imdolce/ws2812b-5050-10x10/schematic/SCH_5050-v1.1_1-P1_2026-10-26.png

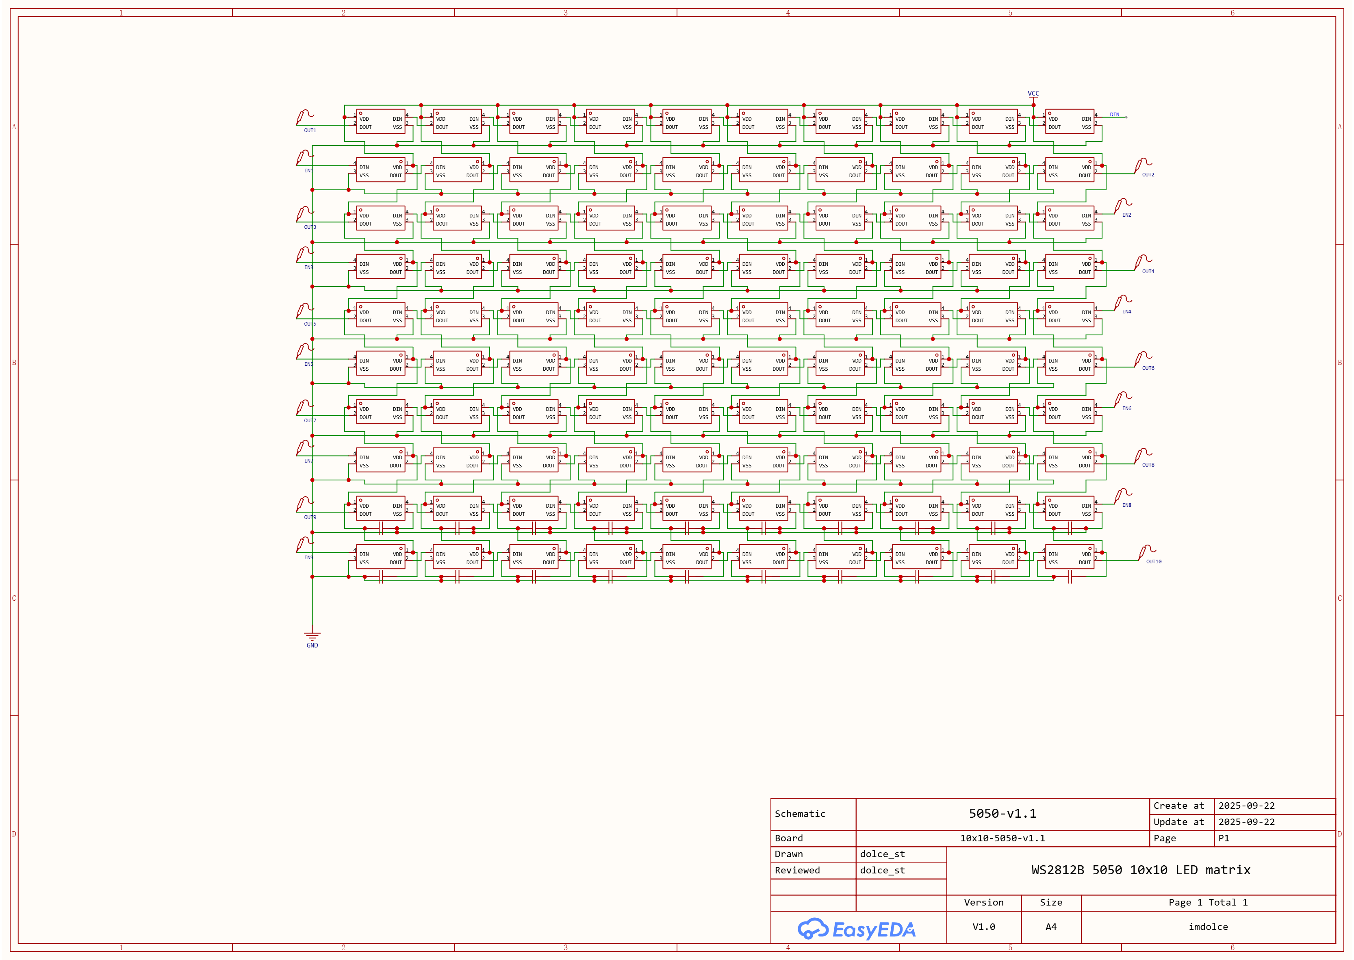
schematic/SCH_5050-v1.1_1-P1_2026-10-26.png
