imdolce/ws2812b-5050-10x10/cad/3D_5050-v1_2026-10-26.step

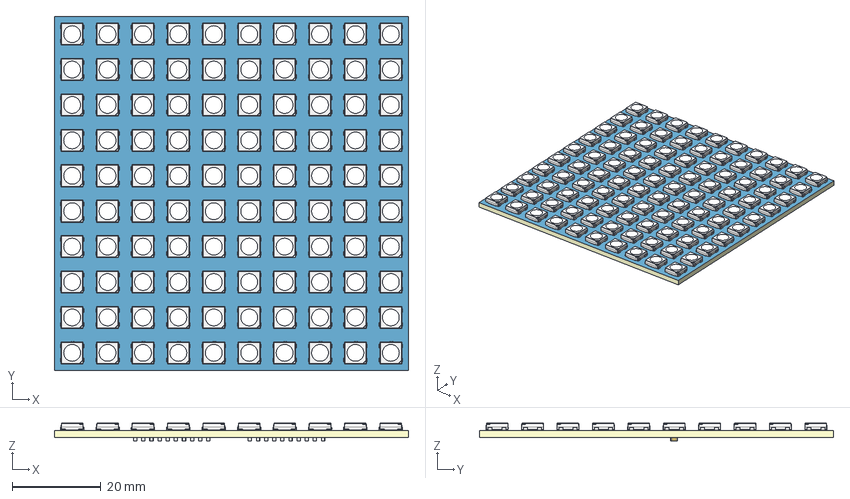
[picture p7: CAD file, 2026-10-26]
cad/3D_5050-v1_2026-10-26.step
80.0 x 80.0 x 4.01 mm
Board~ebgt
TopCopper~ebgt
BottomCopper~ebgt
TopSilkscreen~ebgt
BottomSilkscreen~ebgt
TopFpcStiffener~ebgt
BottomFpcStiffener~ebgt
C0603~C0603_L1.6-W0.8-H0.8~Ra7H x 20
LED-SMD_4P-L5.0-W5.0-TL-1~LED-SMD_4P-L5.0-W5.0-H1.6-P3.2~lCxL x 100
