imdolce/ws2812b-5050-10x10/schematic/SCH_5050-v1.1_2026-10-26.pdf

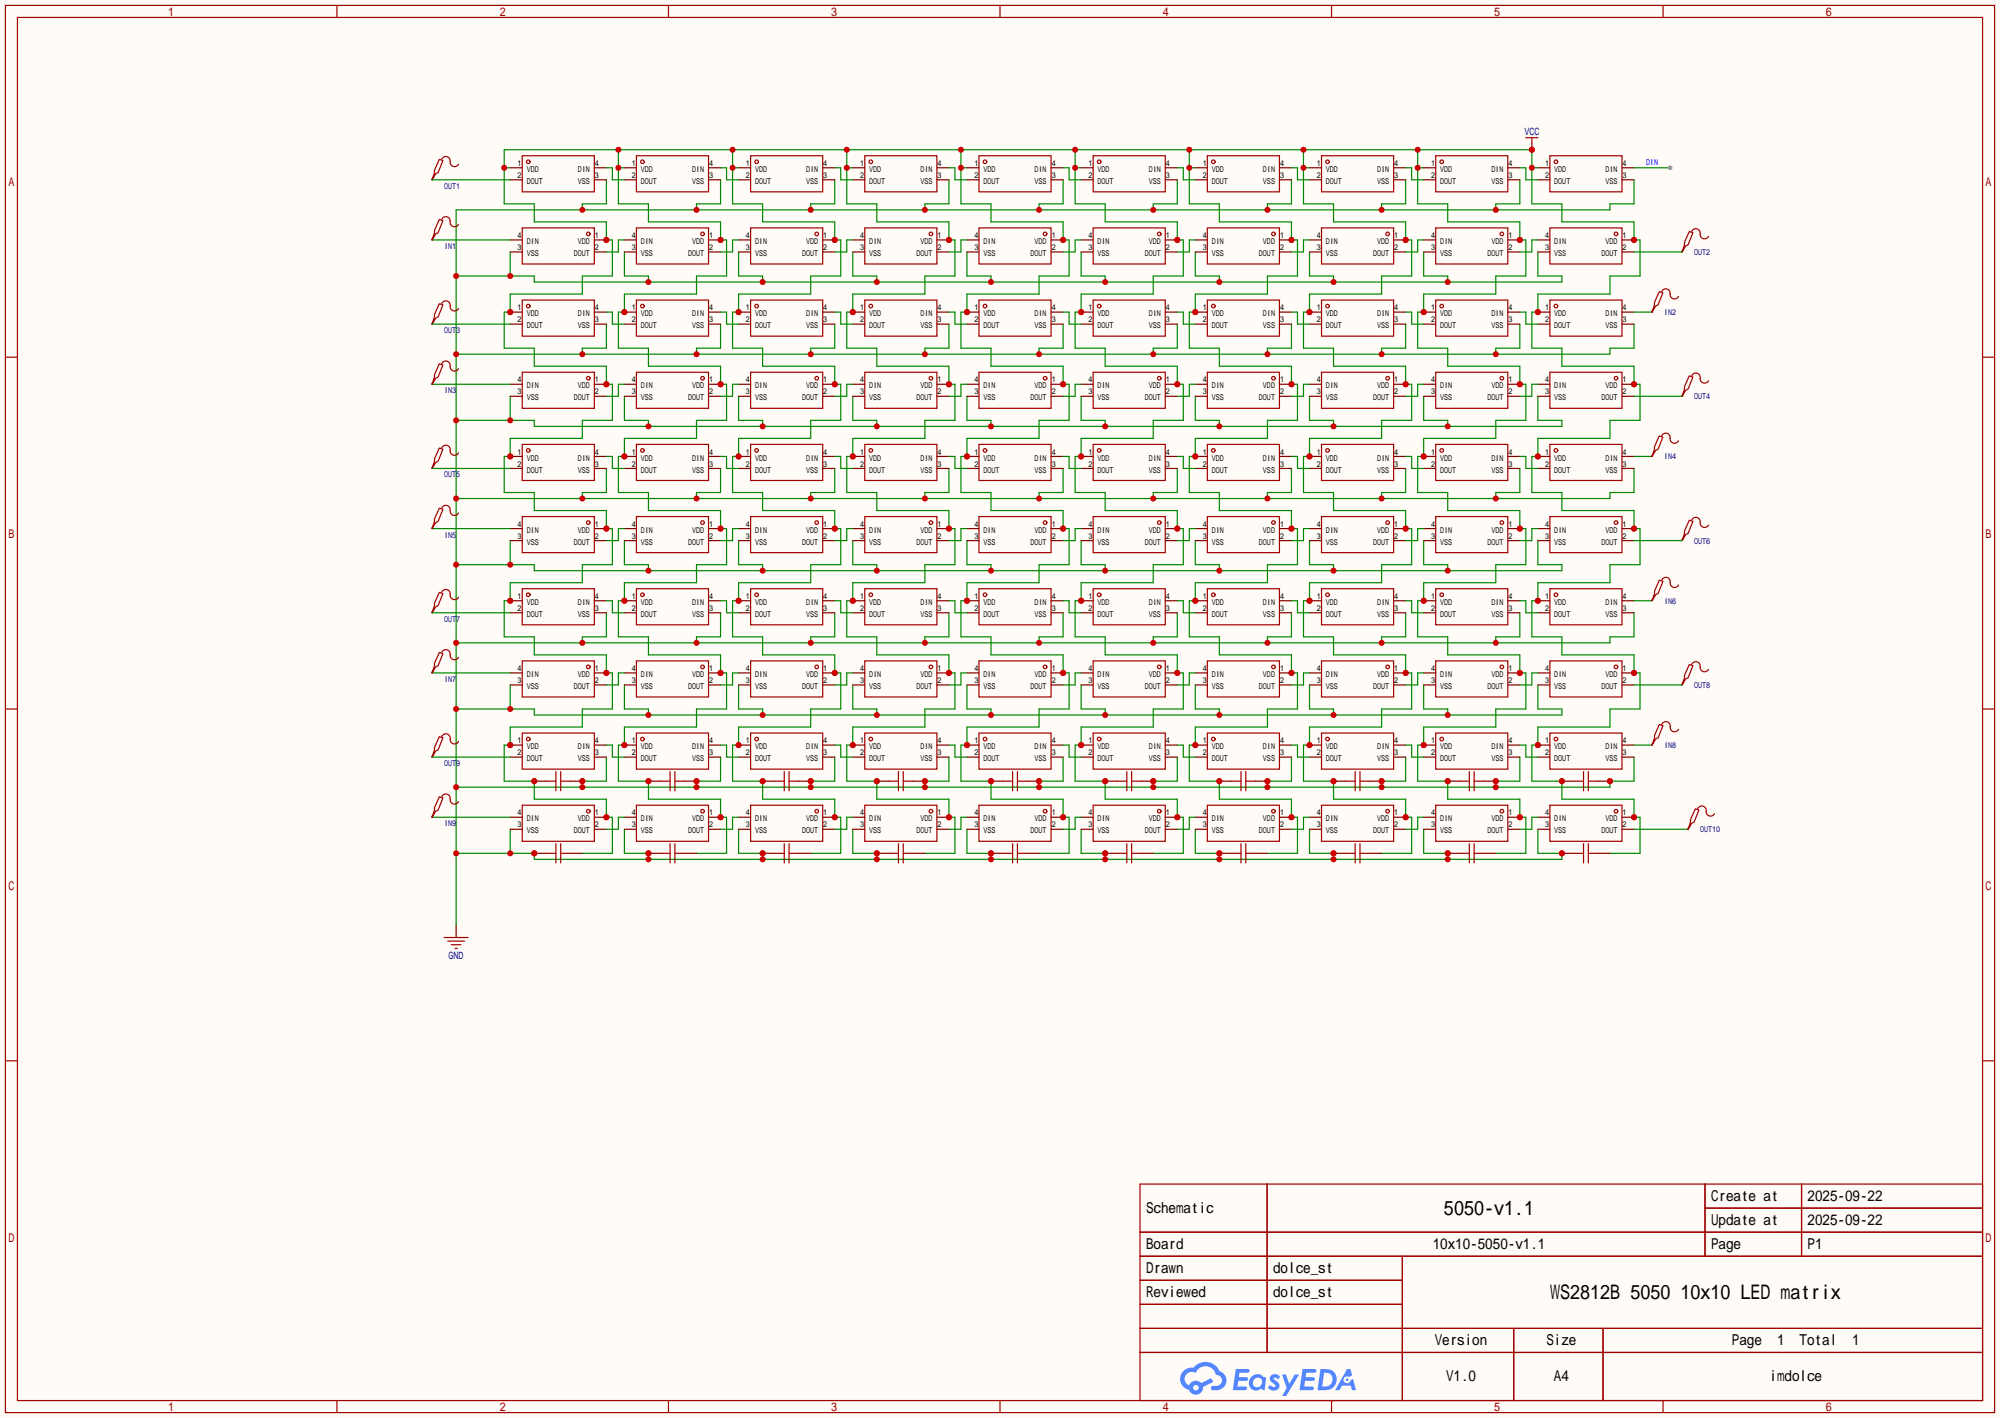
[picture p8: page 1]

Schematic | 5050-v1.1 | Create at | 2025-09-22

Update at | 2025-09-22

Board | 10x10-5050-v1.1 | Page | P1
Drawn | dolce_st | WS2812B 5050 10x10 LED matrix
Reviewed | dolce_st

Version | Size | Page 1 Total 1

V1.0 | A4 | imdolce
