imdolce/ws2812b-5050-10x10/(notices)

Notices in the files:
README.md:
License: CERN OHL-P v2
